Moetez-Fradi/Presentation-Selecao-TRSYP/pitch/web-deck-preview/s09.jpg

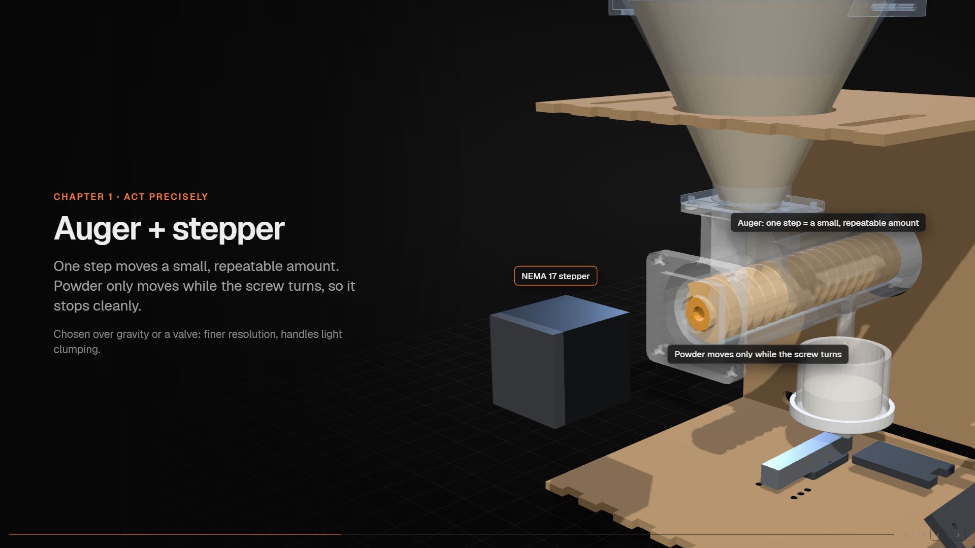
pitch/web-deck-preview/s09.jpg
