Moetez-Fradi/Presentation-Selecao-TRSYP/pitch/web-deck-preview/s16.jpg

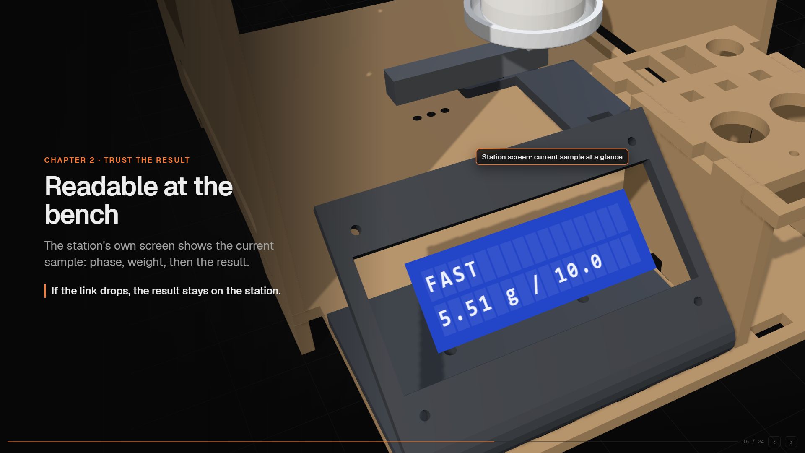
pitch/web-deck-preview/s16.jpg
