Moetez-Fradi/Presentation-Selecao-TRSYP/pitch/screenshots/c-chart2.png

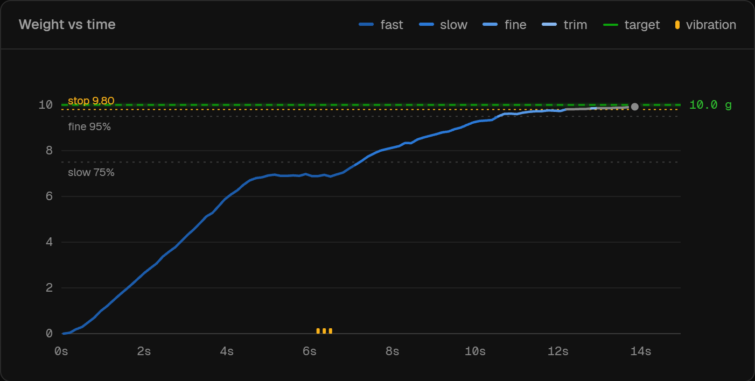
pitch/screenshots/c-chart2.png
