Moetez-Fradi/Presentation-Selecao-TRSYP/pitch/screenshots/c-compare.png

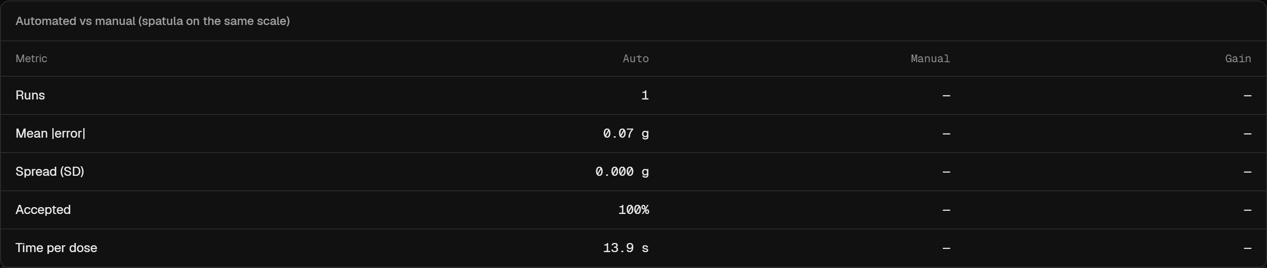
pitch/screenshots/c-compare.png
