Moetez-Fradi/Presentation-Selecao-TRSYP/pitch/screenshots/c-dev.png

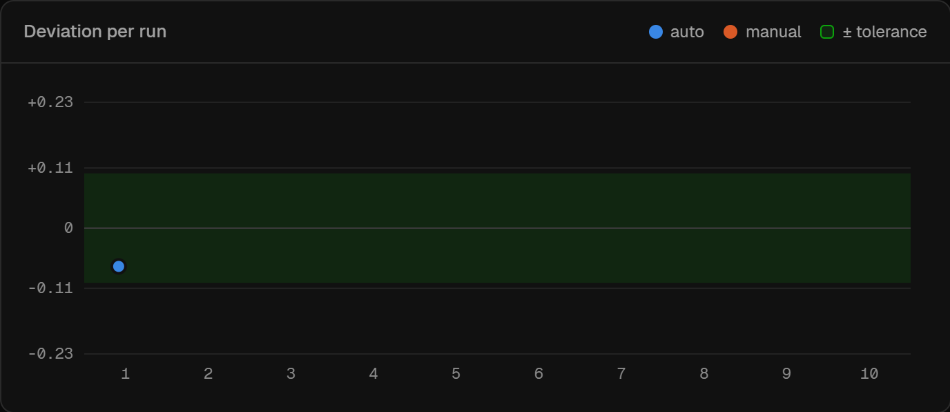
pitch/screenshots/c-dev.png
