Moetez-Fradi/Presentation-Selecao-TRSYP/pitch/screenshots/c-overshoot.png

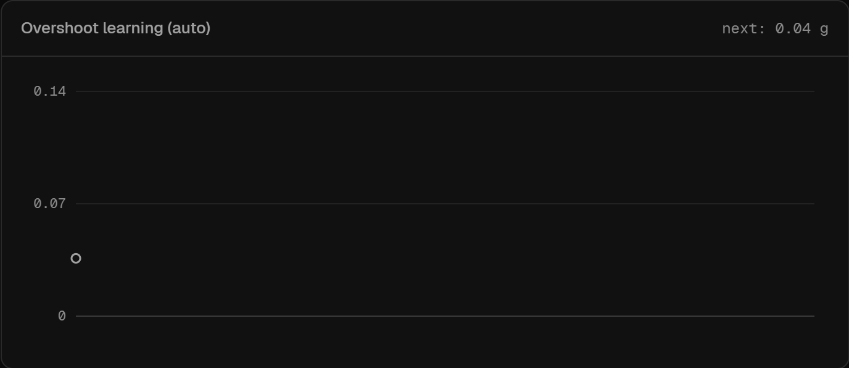
pitch/screenshots/c-overshoot.png
