Moetez-Fradi/Presentation-Selecao-TRSYP/pitch/screenshots/c-record.png

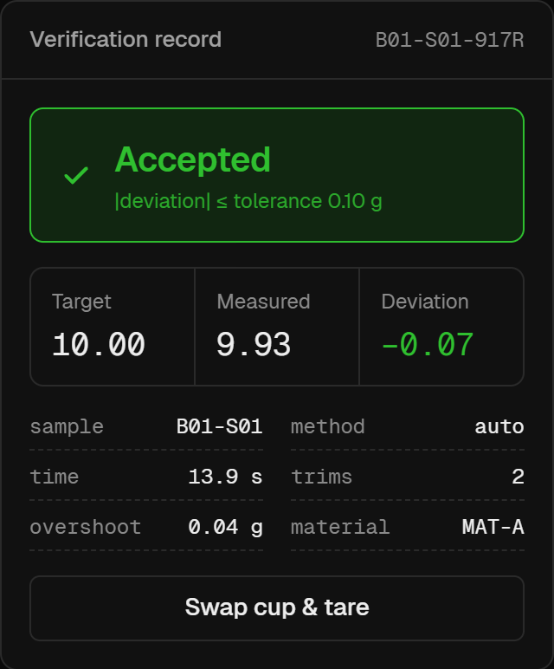
pitch/screenshots/c-record.png
