Moetez-Fradi/Presentation-Selecao-TRSYP/pitch/screenshots/c-twin.png

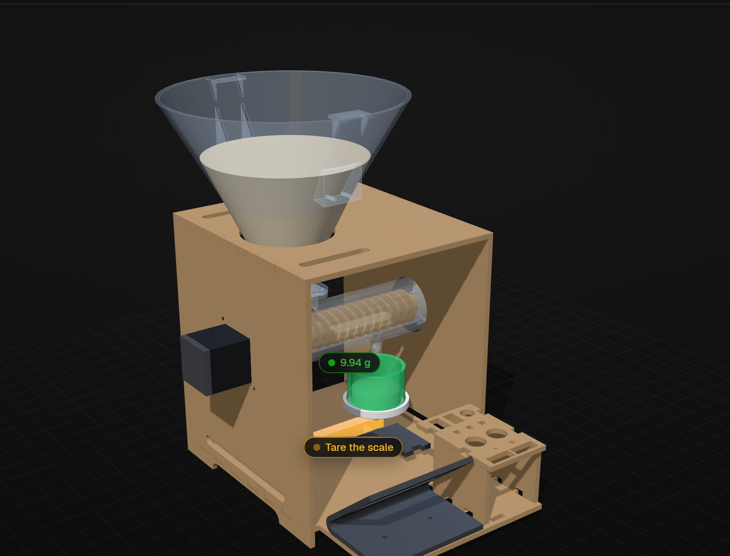
pitch/screenshots/c-twin.png
