Moetez-Fradi/Presentation-Selecao-TRSYP/pitch/screenshots/log.png

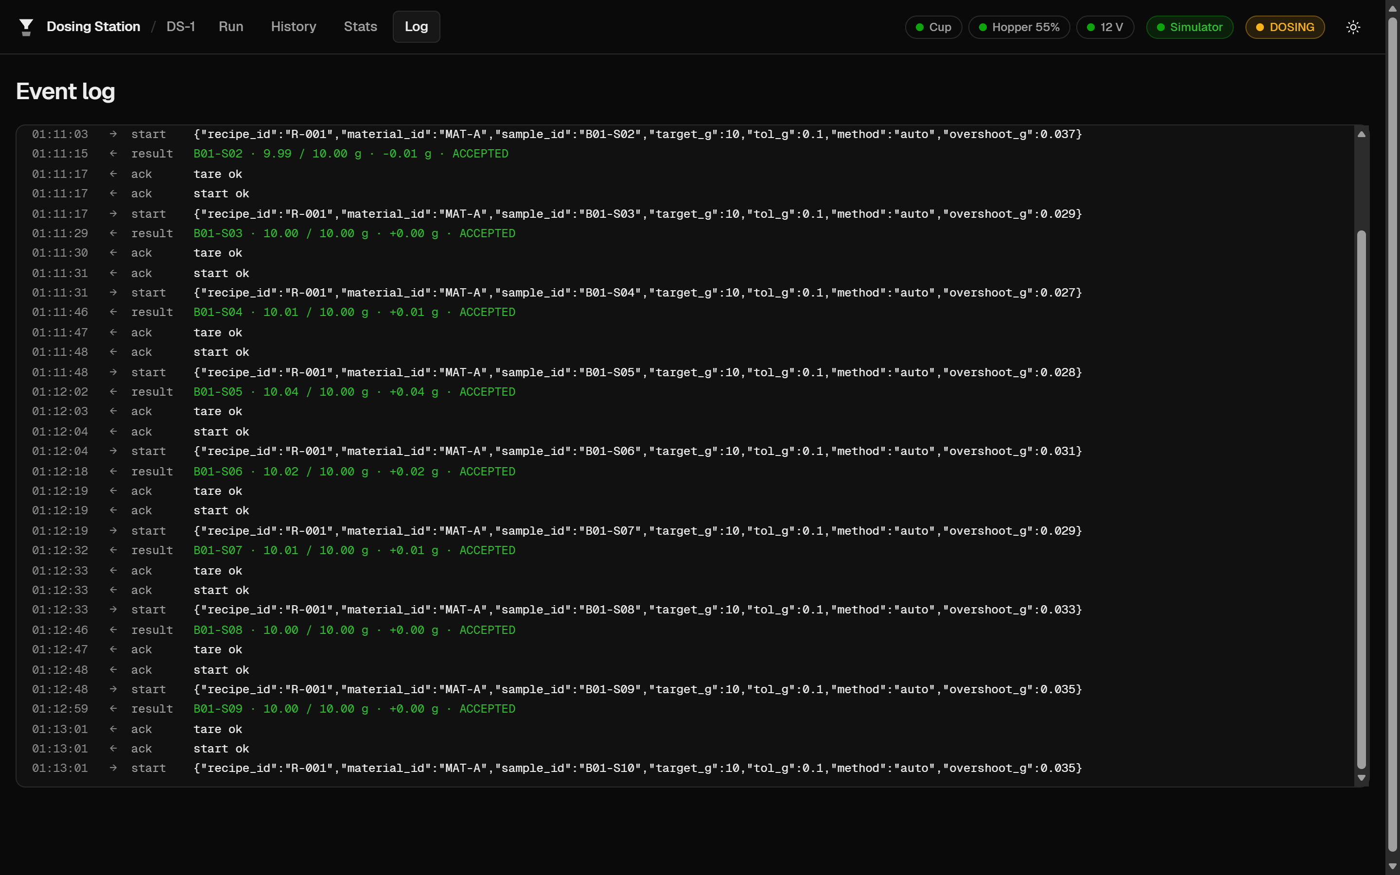
pitch/screenshots/log.png
