Moetez-Fradi/Presentation-Selecao-TRSYP/pitch/screenshots/run-dosing.png

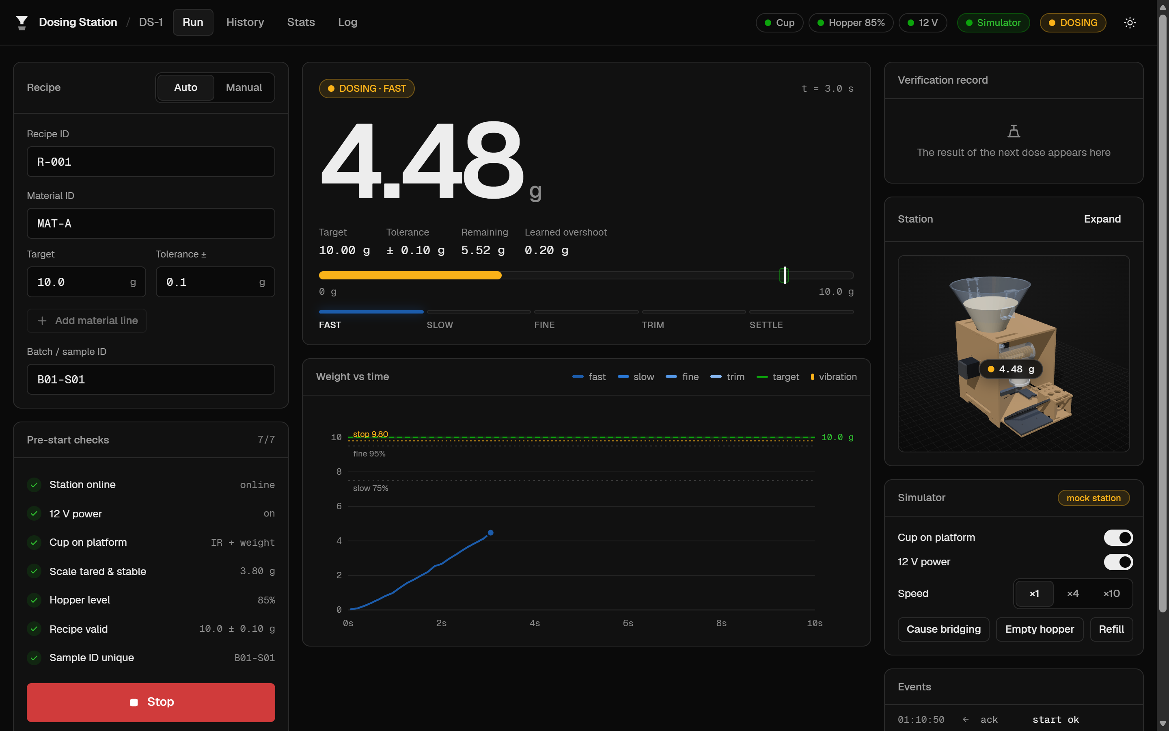
pitch/screenshots/run-dosing.png
