Moetez-Fradi/Presentation-Selecao-TRSYP/pitch/screenshots/stats.png

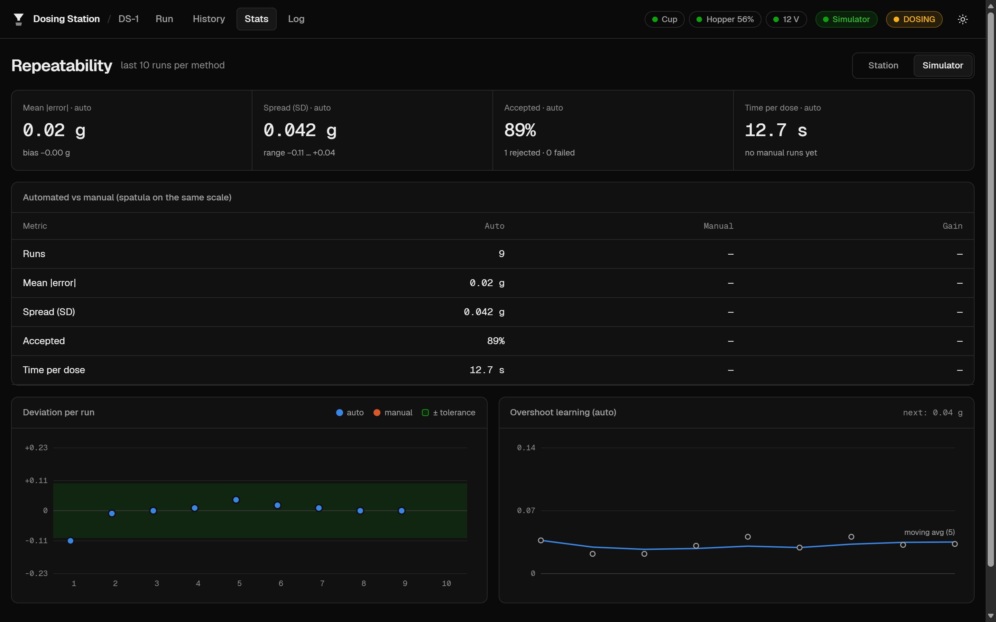
pitch/screenshots/stats.png
