Moetez-Fradi/Presentation-Selecao-TRSYP/pitch/screenshots/twin.png

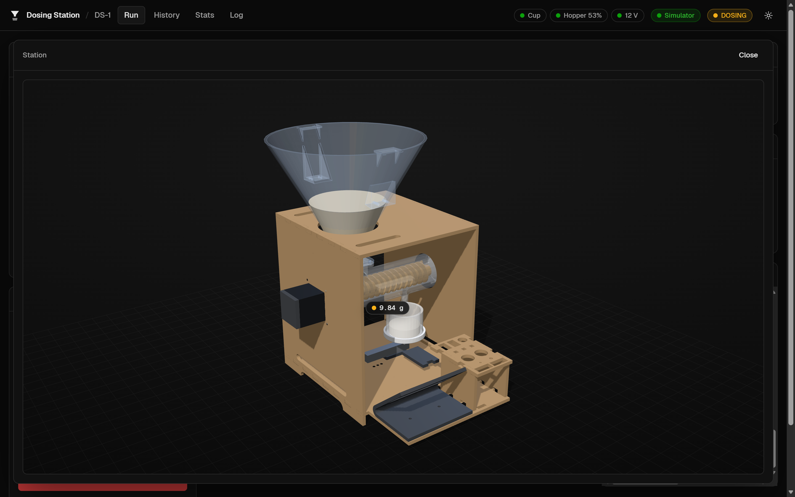
pitch/screenshots/twin.png
