Moetez-Fradi/Presentation-Selecao-TRSYP/pitch/web-deck-preview/s01.jpg

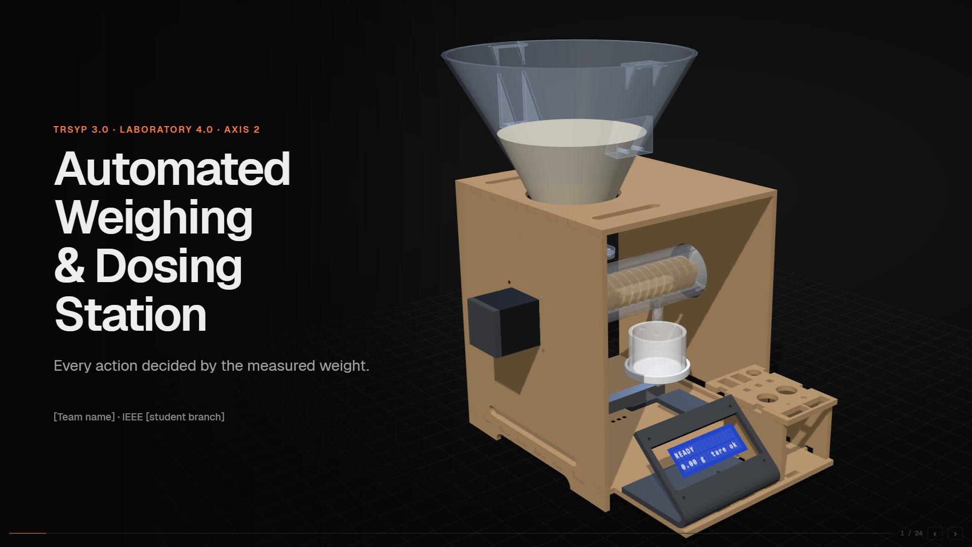
pitch/web-deck-preview/s01.jpg
