Moetez-Fradi/Presentation-Selecao-TRSYP/pitch/web-deck-preview/s02.jpg

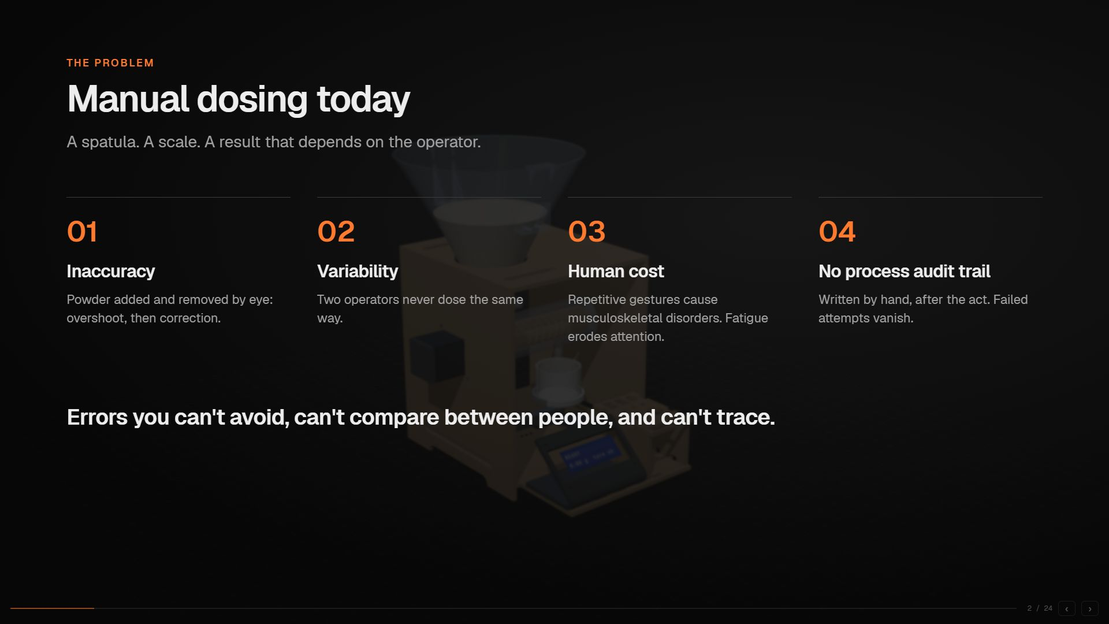
pitch/web-deck-preview/s02.jpg
