Moetez-Fradi/Presentation-Selecao-TRSYP/pitch/web-deck-preview/s03.jpg

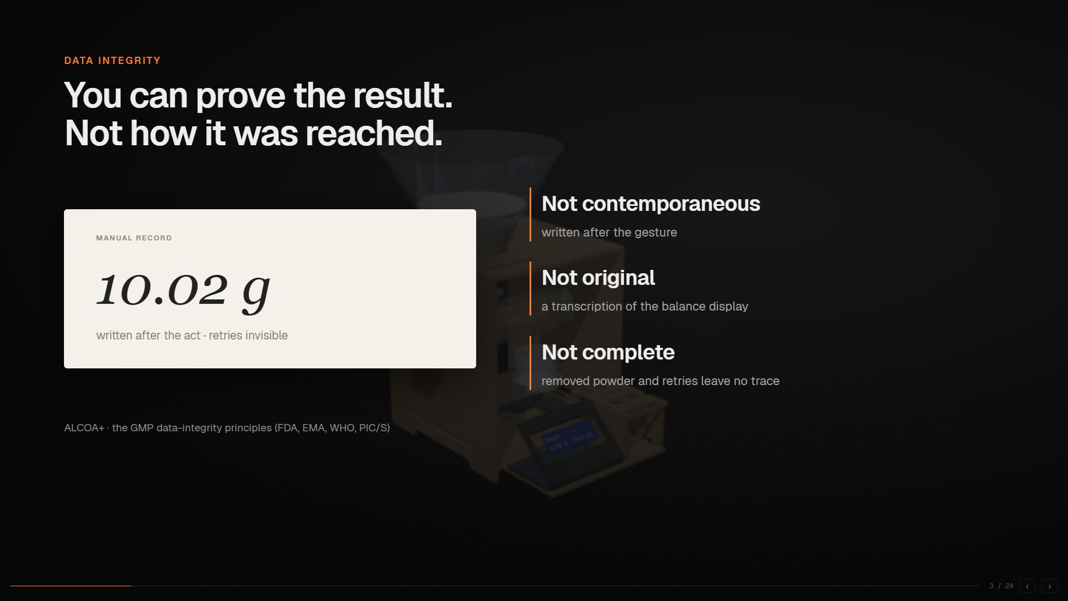
pitch/web-deck-preview/s03.jpg
