Moetez-Fradi/Presentation-Selecao-TRSYP/pitch/web-deck-preview/s04.jpg

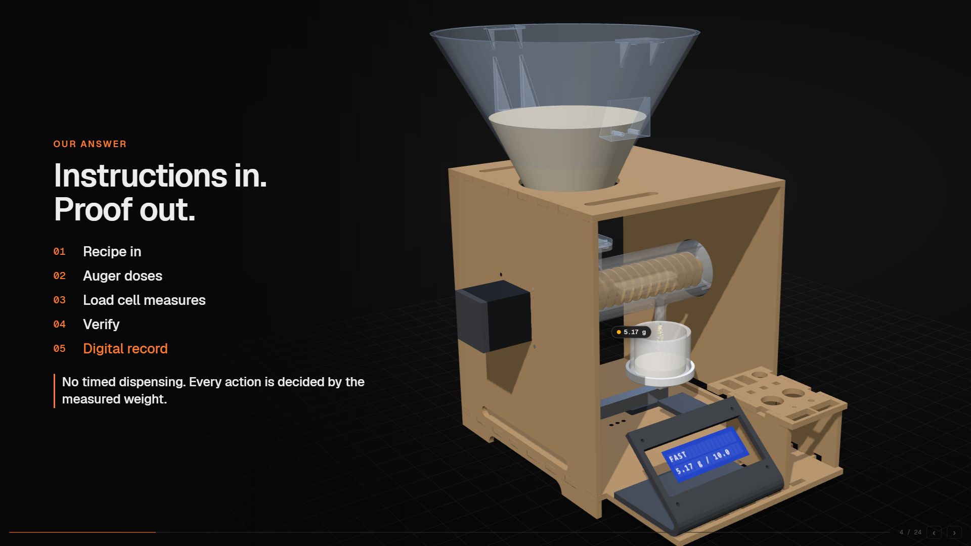
pitch/web-deck-preview/s04.jpg
