Moetez-Fradi/Presentation-Selecao-TRSYP/pitch/web-deck-preview/s05.jpg

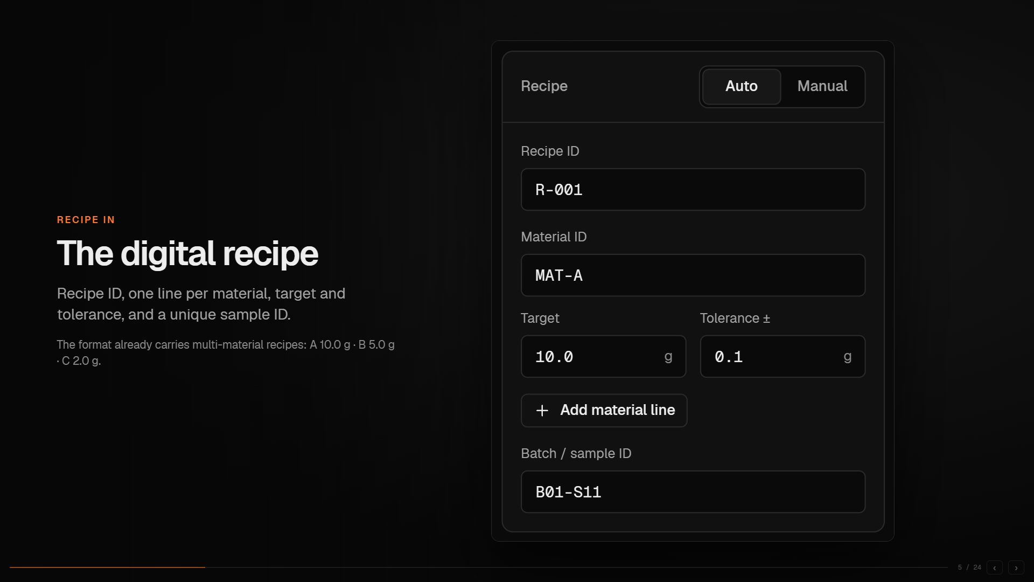
pitch/web-deck-preview/s05.jpg
