Moetez-Fradi/Presentation-Selecao-TRSYP/pitch/web-deck-preview/s06.jpg

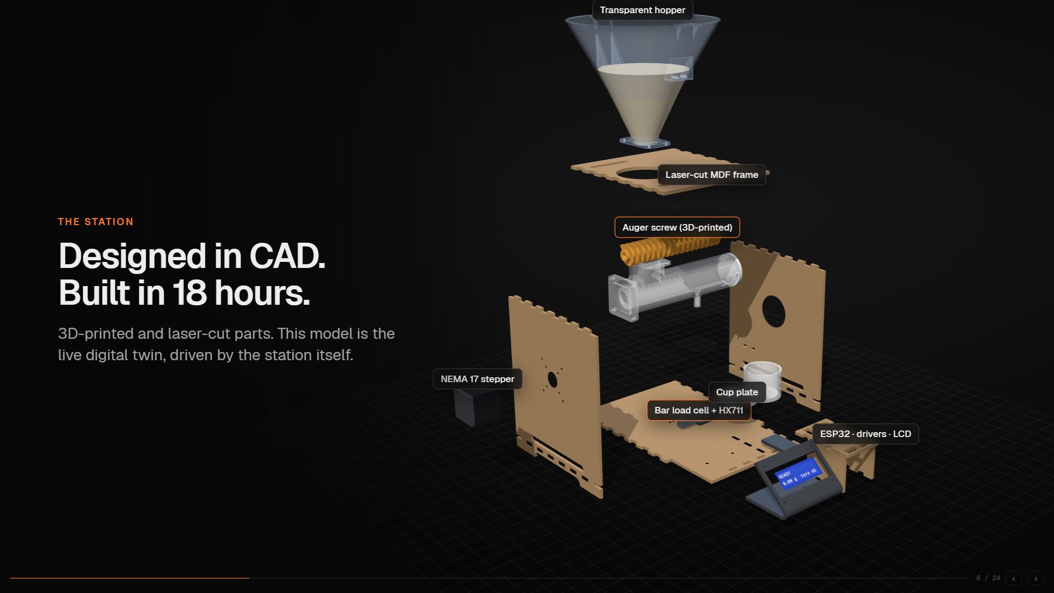
pitch/web-deck-preview/s06.jpg
