Moetez-Fradi/Presentation-Selecao-TRSYP/pitch/web-deck-preview/s07.jpg

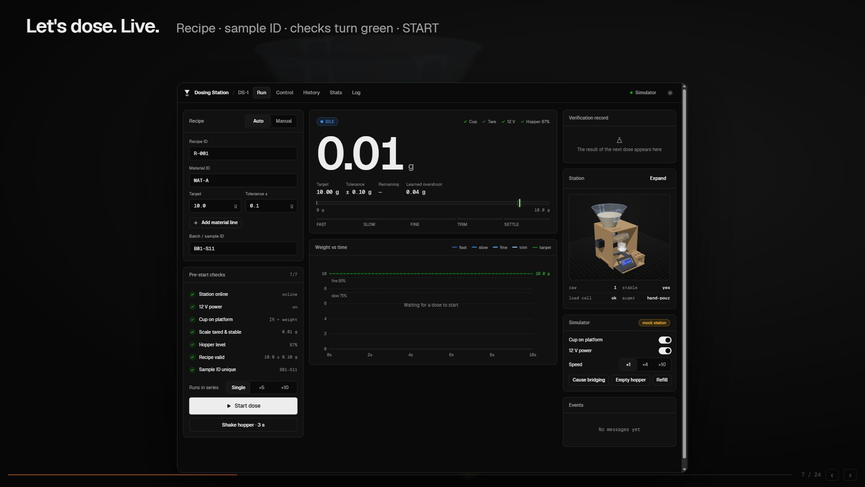
pitch/web-deck-preview/s07.jpg
