Moetez-Fradi/Presentation-Selecao-TRSYP/pitch/web-deck-preview/s08.jpg

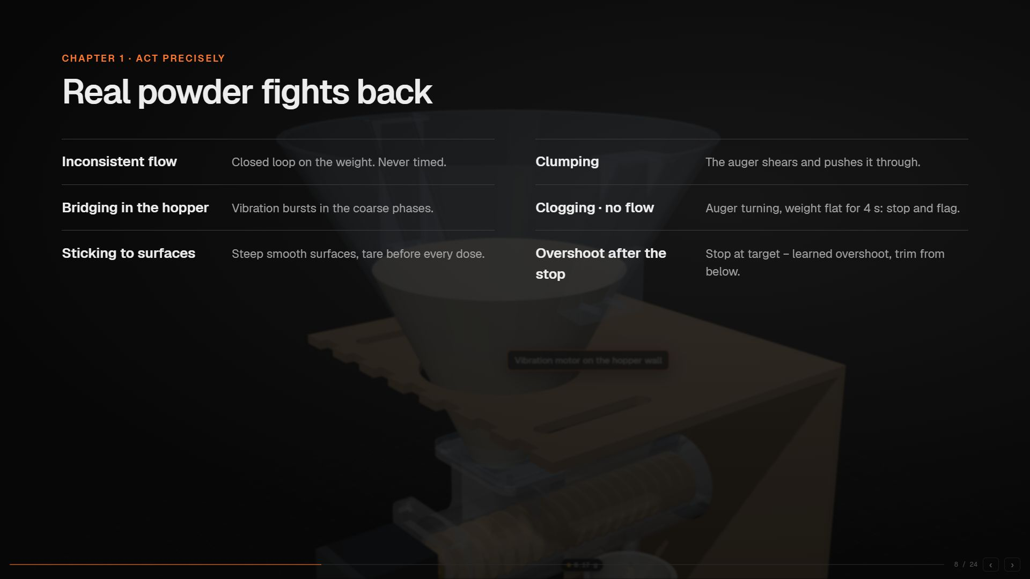
pitch/web-deck-preview/s08.jpg
