Moetez-Fradi/Presentation-Selecao-TRSYP/pitch/web-deck-preview/s10.jpg

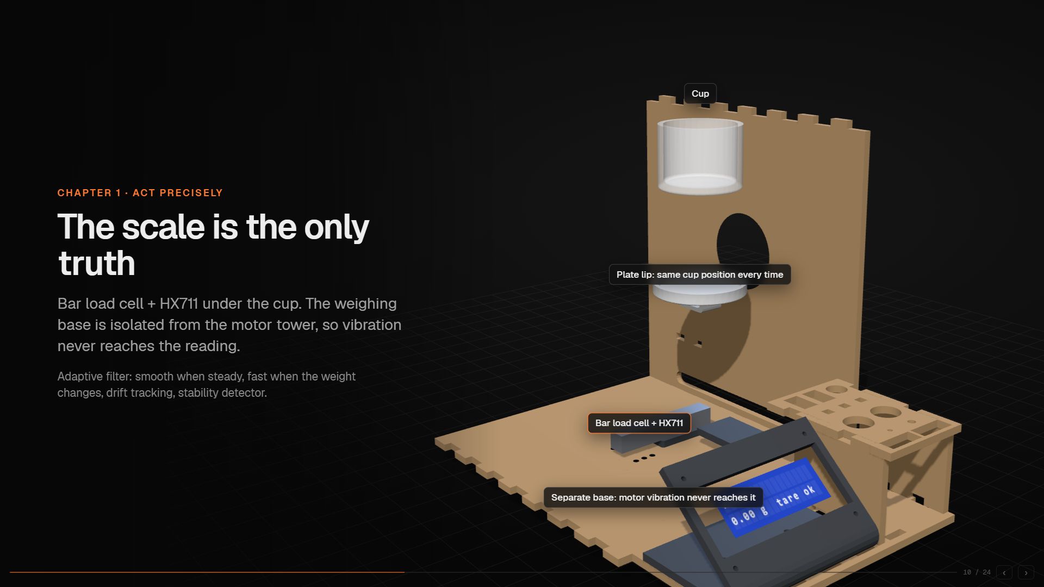
pitch/web-deck-preview/s10.jpg
