Moetez-Fradi/Presentation-Selecao-TRSYP/pitch/web-deck-preview/s11.jpg

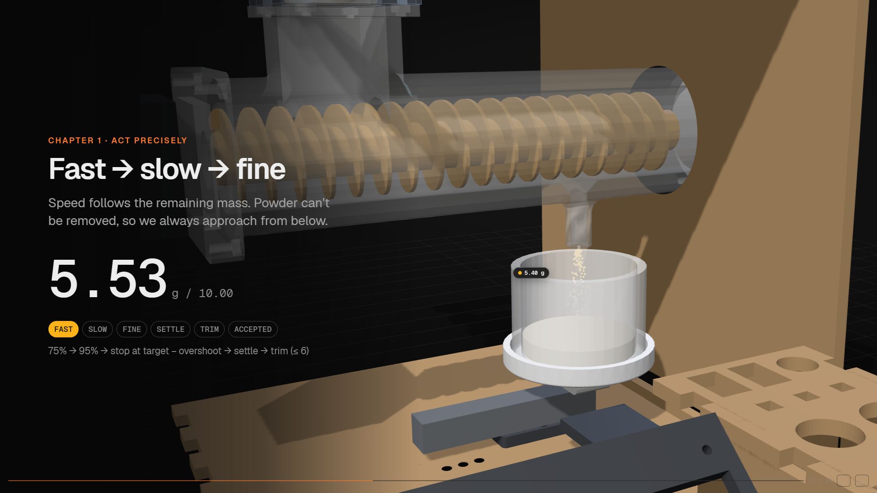
pitch/web-deck-preview/s11.jpg
