Moetez-Fradi/Presentation-Selecao-TRSYP/pitch/web-deck-preview/s12.jpg

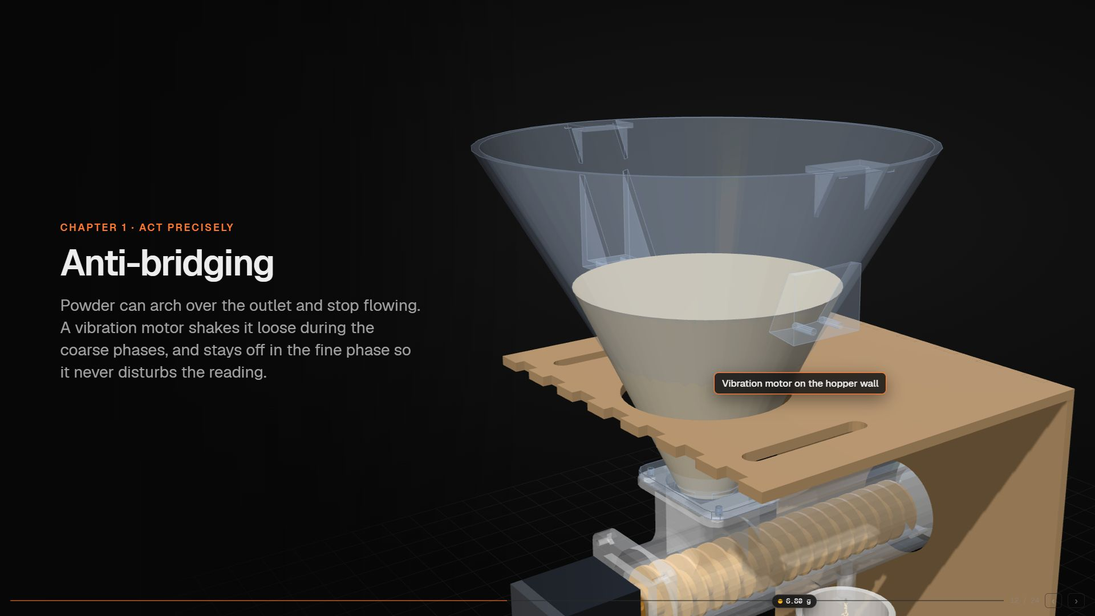
pitch/web-deck-preview/s12.jpg
