Moetez-Fradi/Presentation-Selecao-TRSYP/pitch/web-deck-preview/s13.jpg

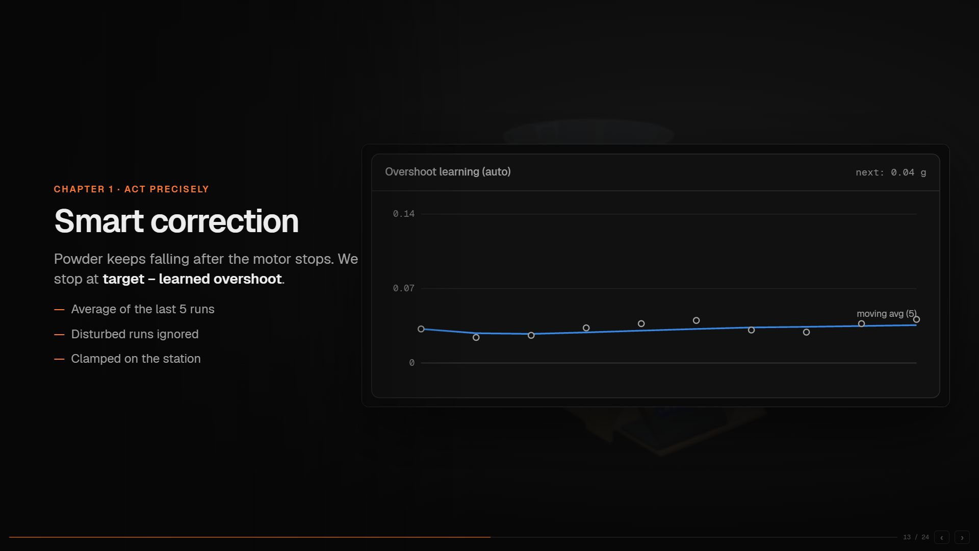
pitch/web-deck-preview/s13.jpg
