Moetez-Fradi/Presentation-Selecao-TRSYP/pitch/web-deck-preview/s14.jpg

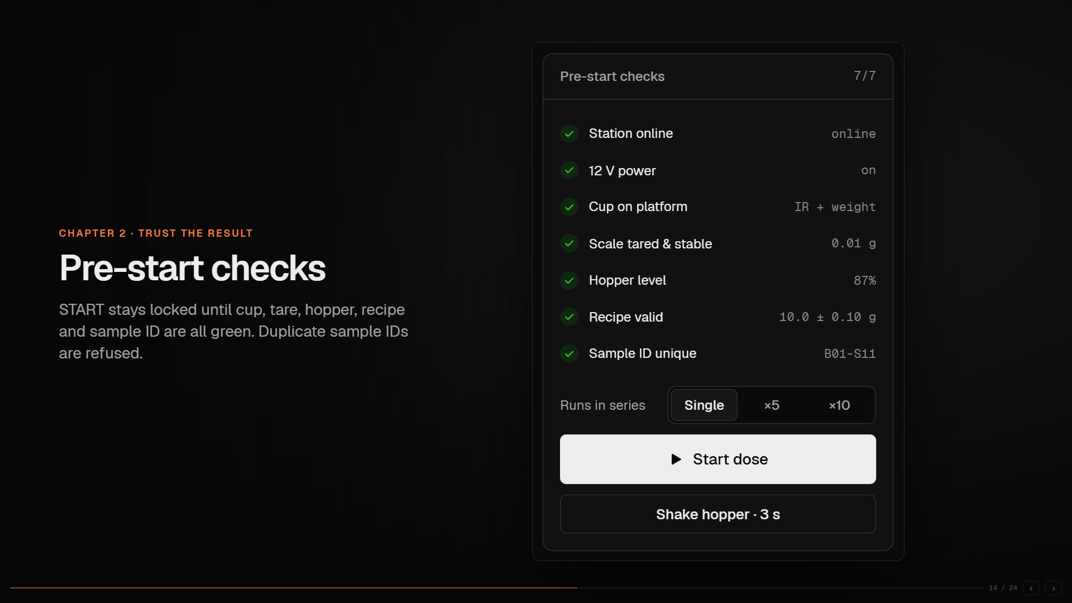
pitch/web-deck-preview/s14.jpg
