Moetez-Fradi/Presentation-Selecao-TRSYP/pitch/web-deck-preview/s15.jpg

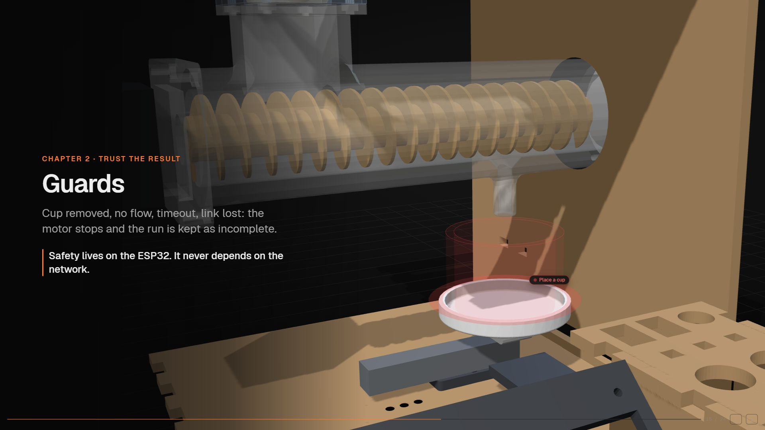
pitch/web-deck-preview/s15.jpg
