Moetez-Fradi/Presentation-Selecao-TRSYP/pitch/web-deck-preview/s17.jpg

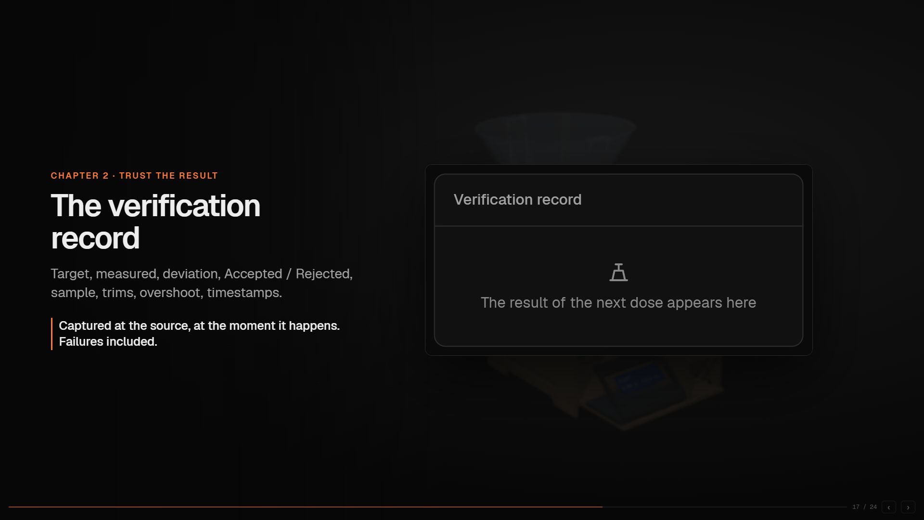
pitch/web-deck-preview/s17.jpg
