Moetez-Fradi/Presentation-Selecao-TRSYP/pitch/web-deck-preview/s18.jpg

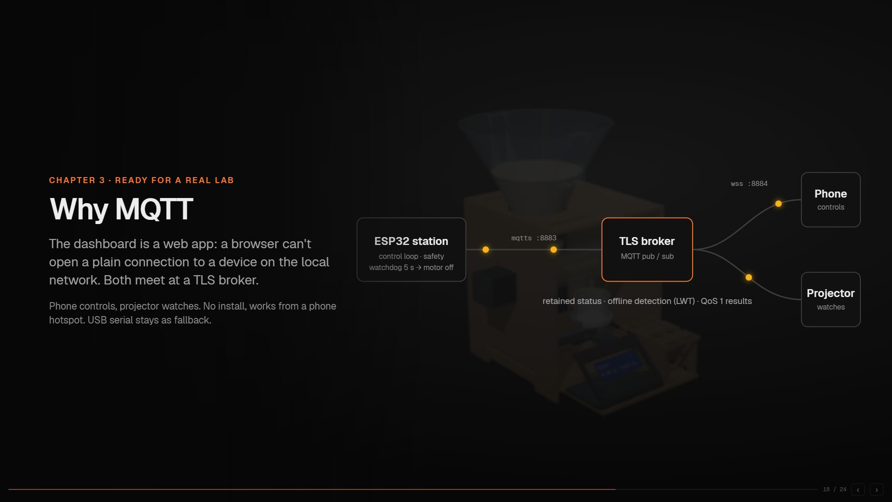
pitch/web-deck-preview/s18.jpg
