Moetez-Fradi/Presentation-Selecao-TRSYP/pitch/web-deck-preview/s19.jpg

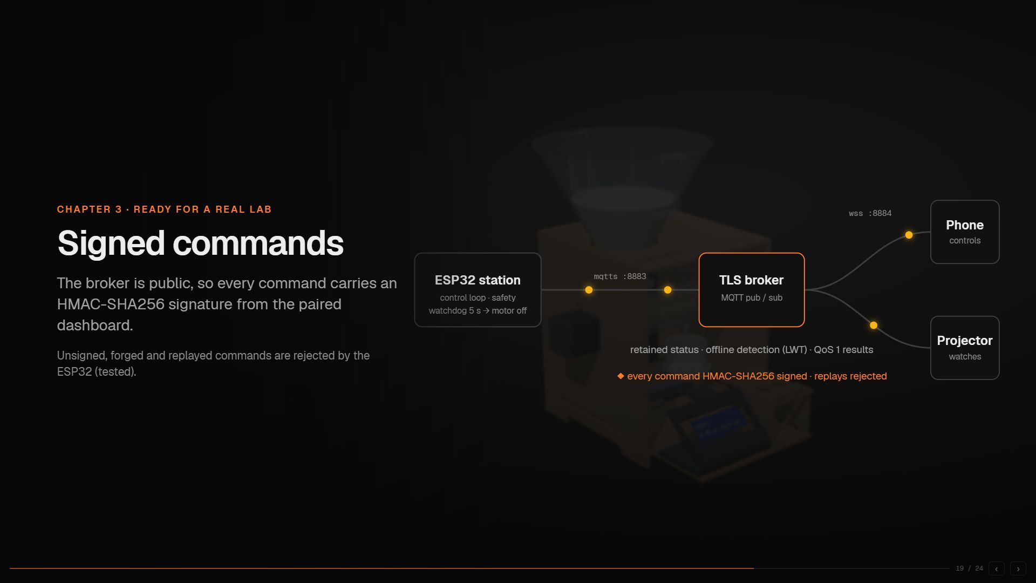
pitch/web-deck-preview/s19.jpg
