Moetez-Fradi/Presentation-Selecao-TRSYP/pitch/web-deck-preview/s20.jpg

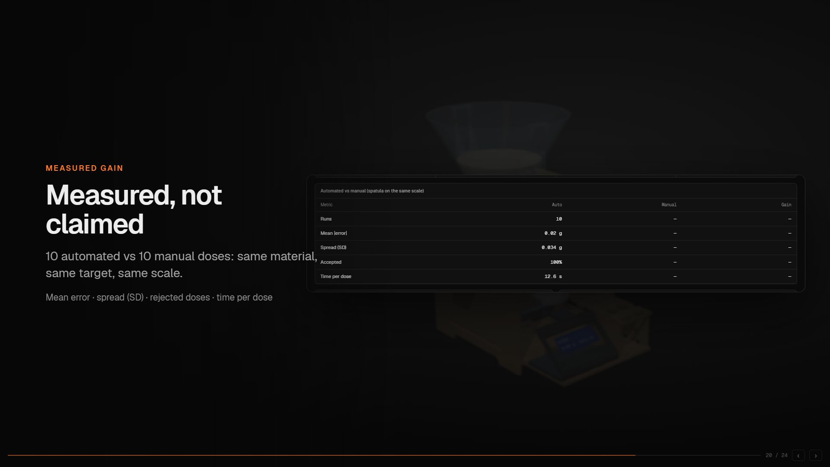
pitch/web-deck-preview/s20.jpg
