Moetez-Fradi/Presentation-Selecao-TRSYP/pitch/web-deck-preview/s21.jpg

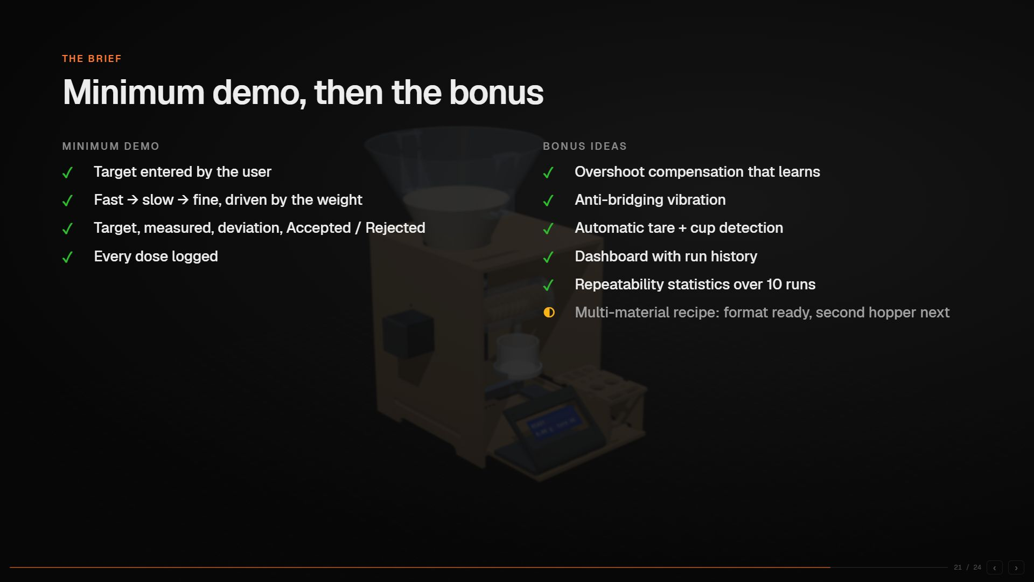
pitch/web-deck-preview/s21.jpg
