Moetez-Fradi/Presentation-Selecao-TRSYP/pitch/web-deck-preview/s22.jpg

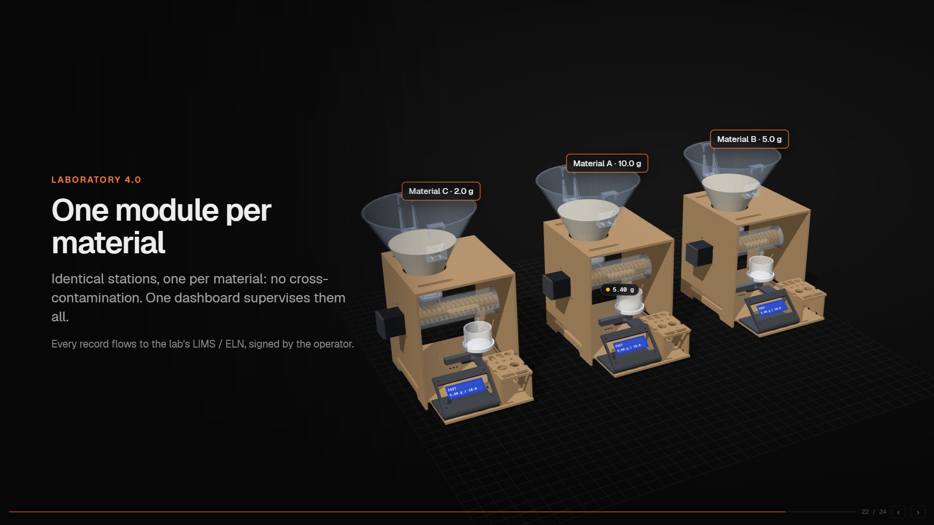
pitch/web-deck-preview/s22.jpg
