Moetez-Fradi/Presentation-Selecao-TRSYP/pitch/web-deck-preview/s23.jpg

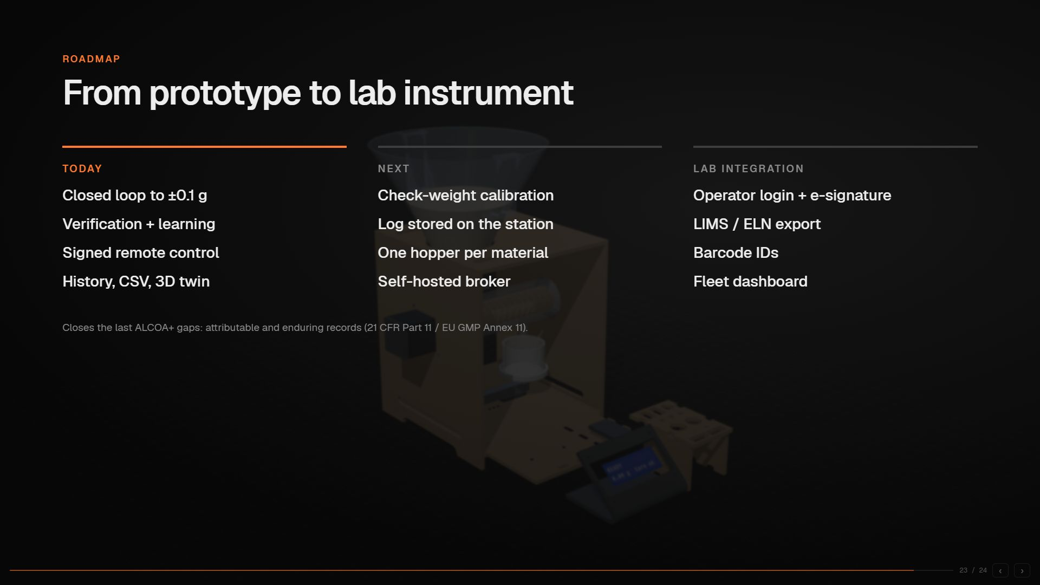
pitch/web-deck-preview/s23.jpg
