Moetez-Fradi/Presentation-Selecao-TRSYP/pitch/web-deck-preview/s24.jpg

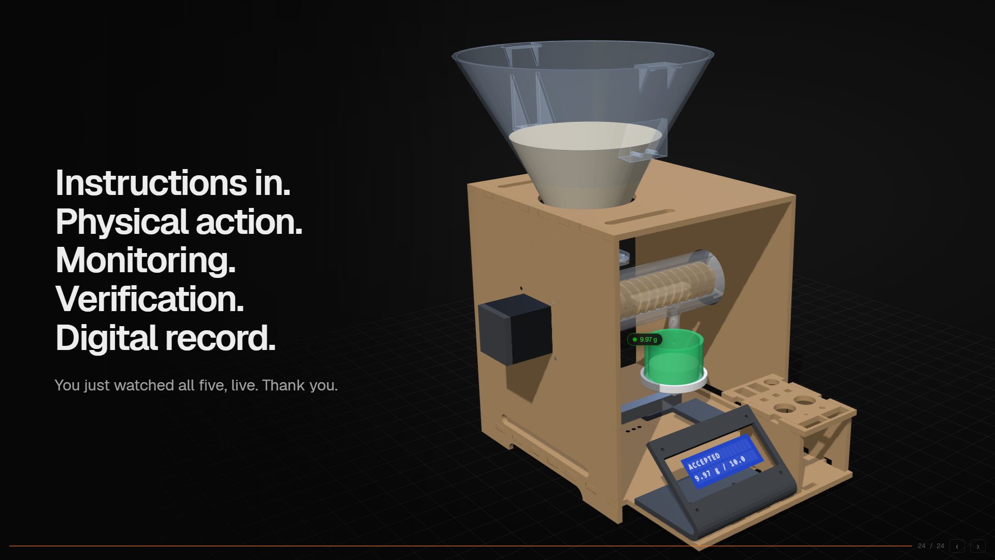
pitch/web-deck-preview/s24.jpg
