Moetez-Fradi/Presentation-Selecao-TRSYP/dashboard/public/models/loadcell-fixer.stl

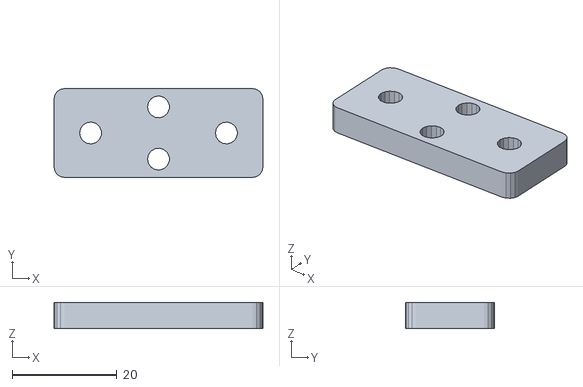
[picture p36: CAD file, 2026-10-17]
dashboard/public/models/loadcell-fixer.stl
40.0 x 17.0 x 5.00
