Moetez-Fradi/Presentation-Selecao-TRSYP/dashboard/public/models/right-side.dxf

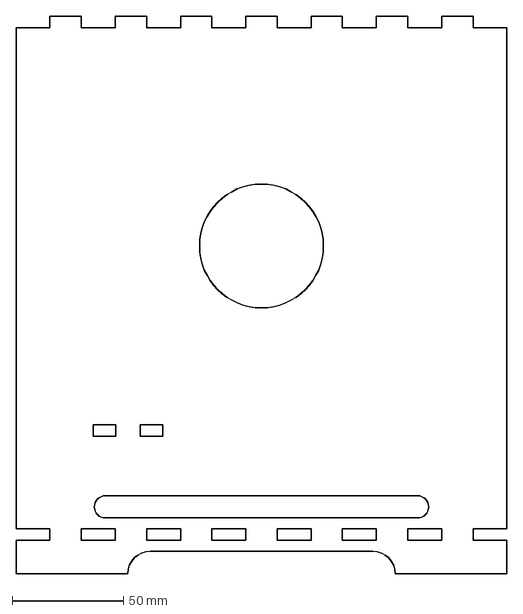
[picture p37: CAD file, 2026-10-17]
dashboard/public/models/right-side.dxf
220.0 x 250.0 mm
