Moetez-Fradi/Presentation-Selecao-TRSYP/dashboard/public/models/left-side-motor.dxf

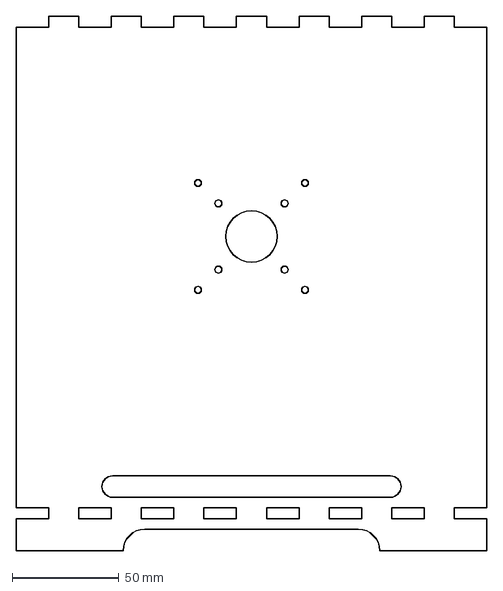
[picture p38: CAD file, 2026-10-17]
dashboard/public/models/left-side-motor.dxf
220.0 x 250.0 mm
