Moetez-Fradi/Presentation-Selecao-TRSYP/dashboard/public/models/cup-plate.stl

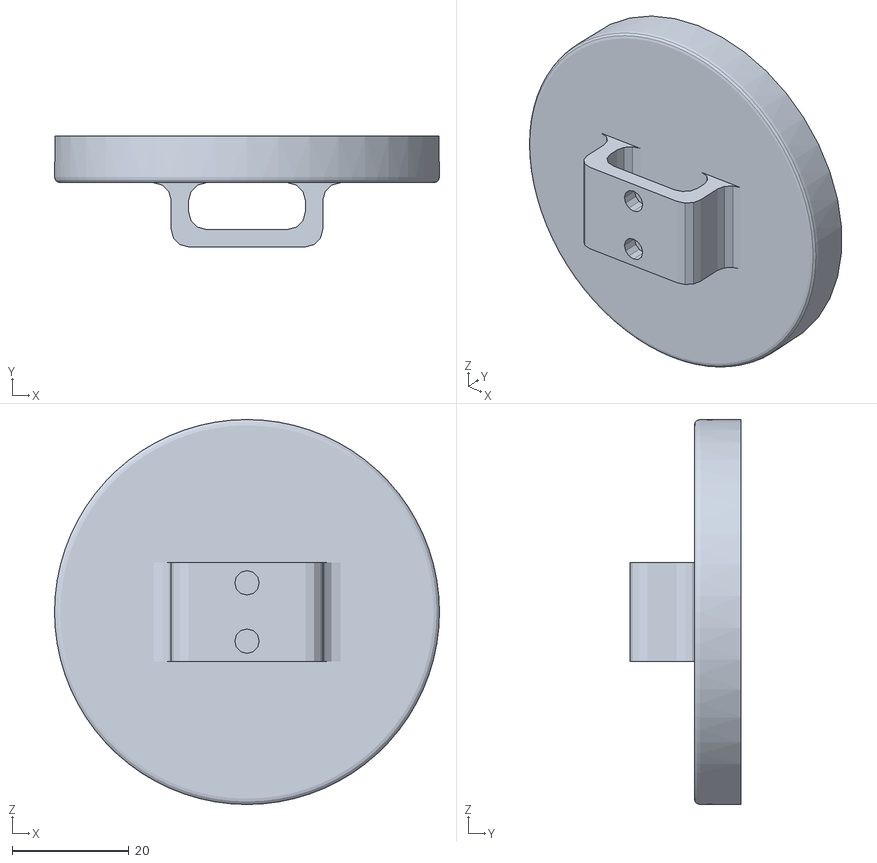
[picture p39: CAD file, 2026-10-17]
dashboard/public/models/cup-plate.stl
66.0 x 19.0 x 66.0
