Moetez-Fradi/Presentation-Selecao-TRSYP/dashboard/public/models/buttons-platform-upper.dxf

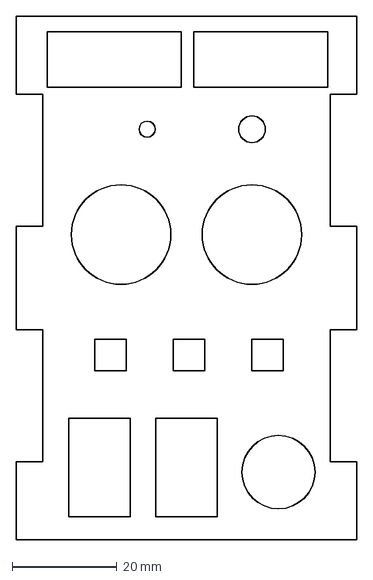
[picture p40: CAD file, 2026-10-17]
dashboard/public/models/buttons-platform-upper.dxf
65.0 x 100.0 mm
