Moetez-Fradi/Presentation-Selecao-TRSYP/dashboard/public/models/base-front-support.dxf

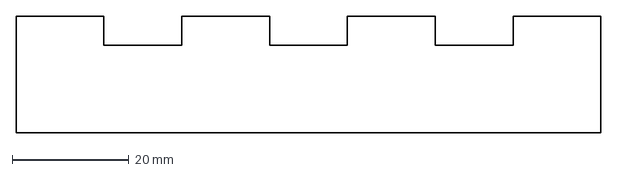
[picture p41: CAD file, 2026-10-17]
dashboard/public/models/base-front-support.dxf
100.0 x 20.0 mm
