Moetez-Fradi/Presentation-Selecao-TRSYP/dashboard/public/models/tube.stl

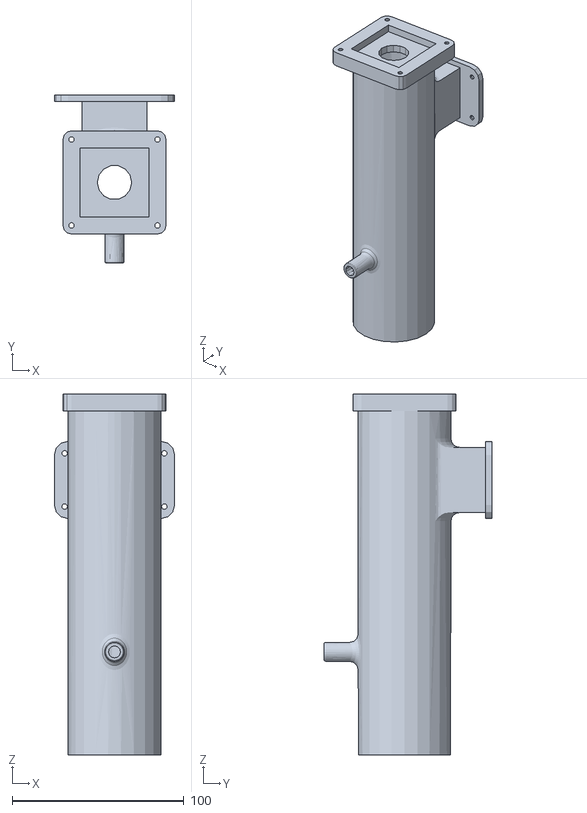
[picture p42: CAD file, 2026-10-17]
dashboard/public/models/tube.stl
70.0 x 98.0 x 210.0
