Moetez-Fradi/Presentation-Selecao-TRSYP/dashboard/public/models/buttons-platform-side.dxf

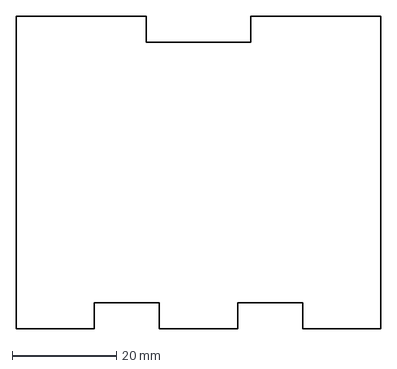
[picture p43: CAD file, 2026-10-17]
dashboard/public/models/buttons-platform-side.dxf
70.0 x 60.0 mm
