Moetez-Fradi/Presentation-Selecao-TRSYP/dashboard/public/models/lower-side.dxf

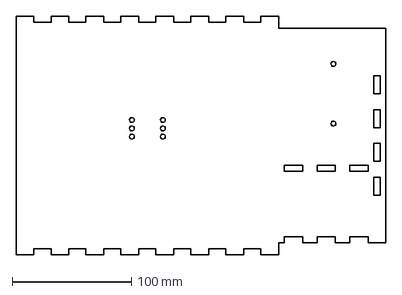
[picture p44: CAD file, 2026-10-17]
dashboard/public/models/lower-side.dxf
310.0 x 200.0 mm
