Moetez-Fradi/Presentation-Selecao-TRSYP/dashboard/public/models/lcd-holder.stl

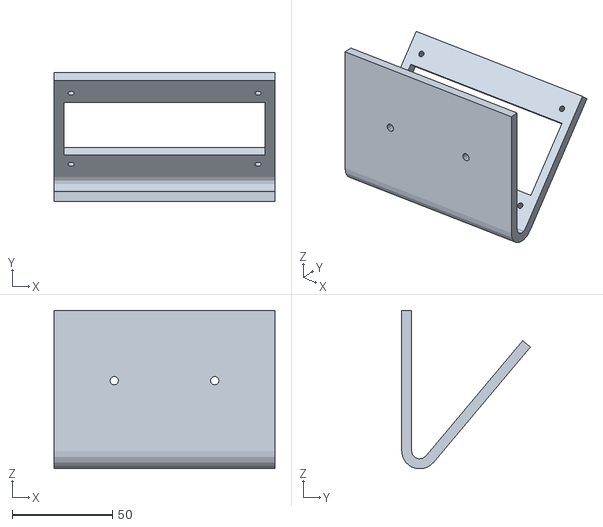
[picture p45: CAD file, 2026-10-17]
dashboard/public/models/lcd-holder.stl
110.0 x 64.1 x 78.9
