Moetez-Fradi/Presentation-Selecao-TRSYP/dashboard/public/models/cup.stl

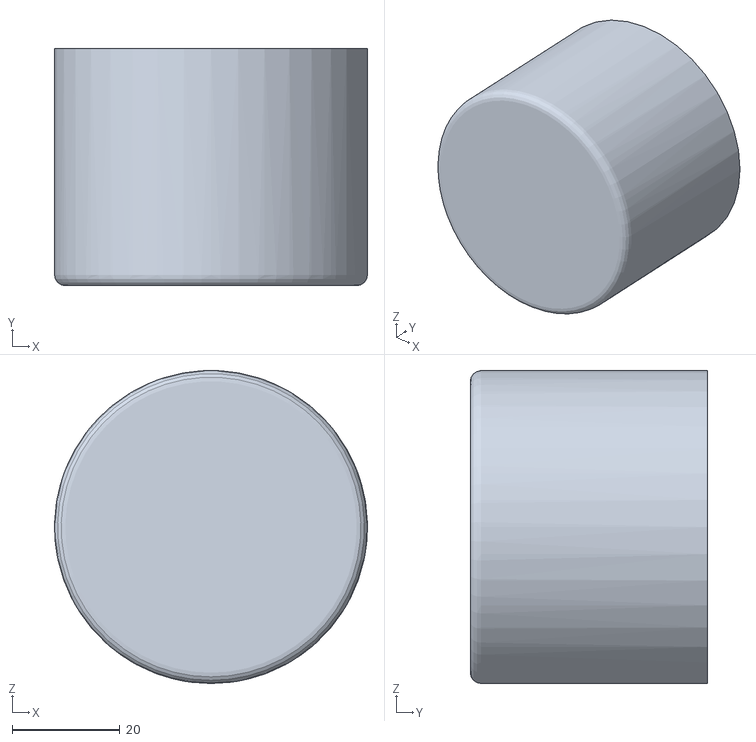
[picture p46: CAD file, 2026-10-17]
dashboard/public/models/cup.stl
58.0 x 44.0 x 58.0
