Moetez-Fradi/Presentation-Selecao-TRSYP/dashboard/public/models/hopper.stl

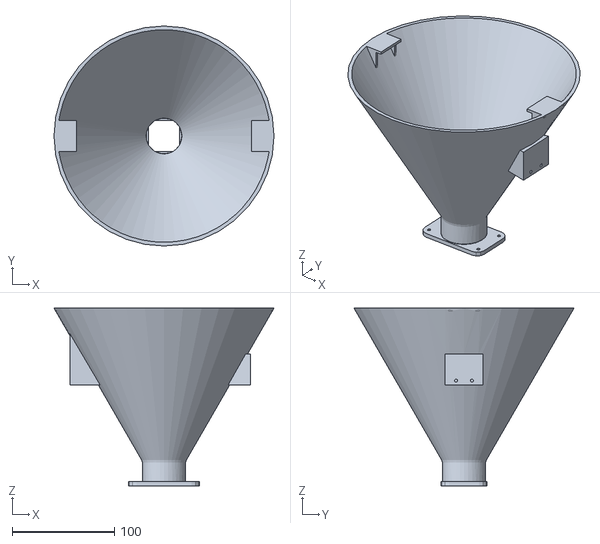
[picture p47: CAD file, 2026-10-17]
dashboard/public/models/hopper.stl
215.6 x 215.6 x 174.0
