Moetez-Fradi/Presentation-Selecao-TRSYP/dashboard/public/models/irsensor-support.dxf

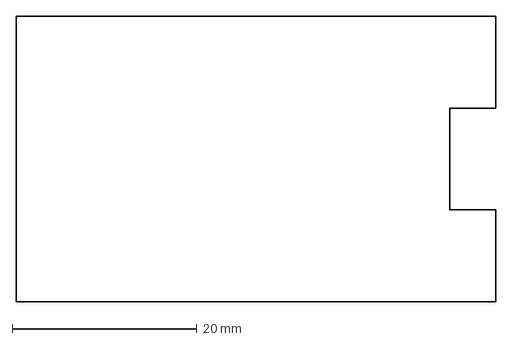
[picture p48: CAD file, 2026-10-17]
dashboard/public/models/irsensor-support.dxf
52.0 x 31.0 mm
