Moetez-Fradi/Presentation-Selecao-TRSYP/dashboard/public/models/upper-side.dxf

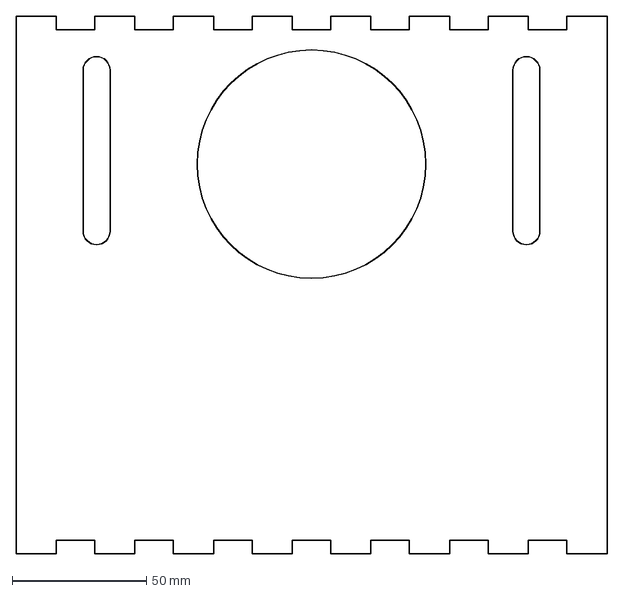
[picture p49: CAD file, 2026-10-17]
dashboard/public/models/upper-side.dxf
220.0 x 200.0 mm
