Moetez-Fradi/Presentation-Selecao-TRSYP/dashboard/public/models/tube-cover.stl

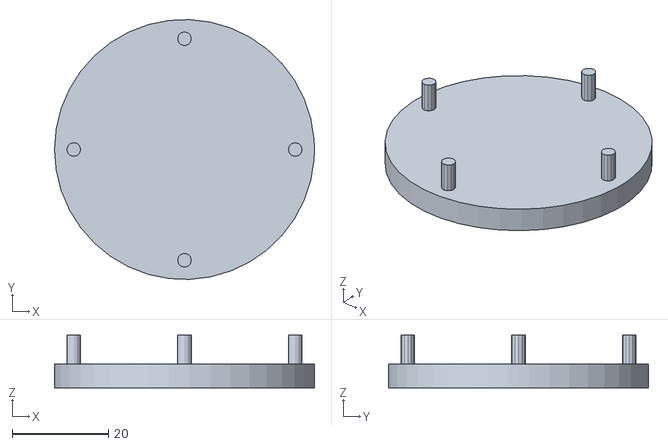
[picture p50: CAD file, 2026-10-17]
dashboard/public/models/tube-cover.stl
54.0 x 54.0 x 11.0
