Moetez-Fradi/Presentation-Selecao-TRSYP/dashboard/public/models/auger.stl

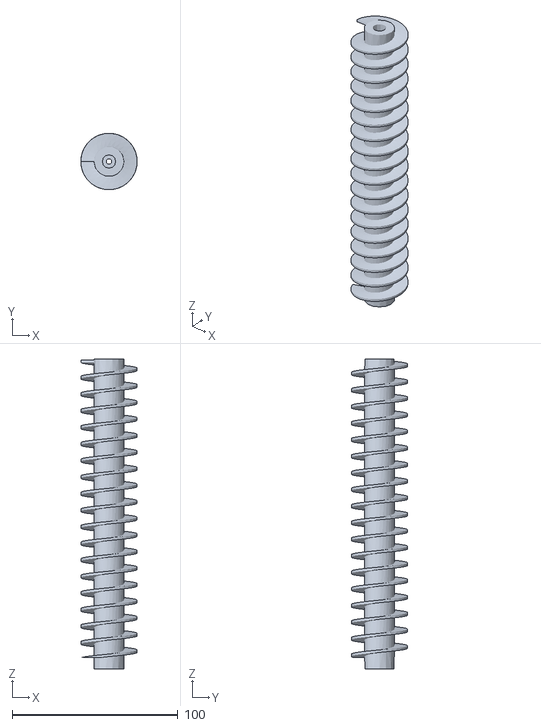
[picture p51: CAD file, 2026-10-17]
dashboard/public/models/auger.stl
34.0 x 34.0 x 187.0
