Moetez-Fradi/Presentation-Selecao-TRSYP/station_esp32_wiring_map.png

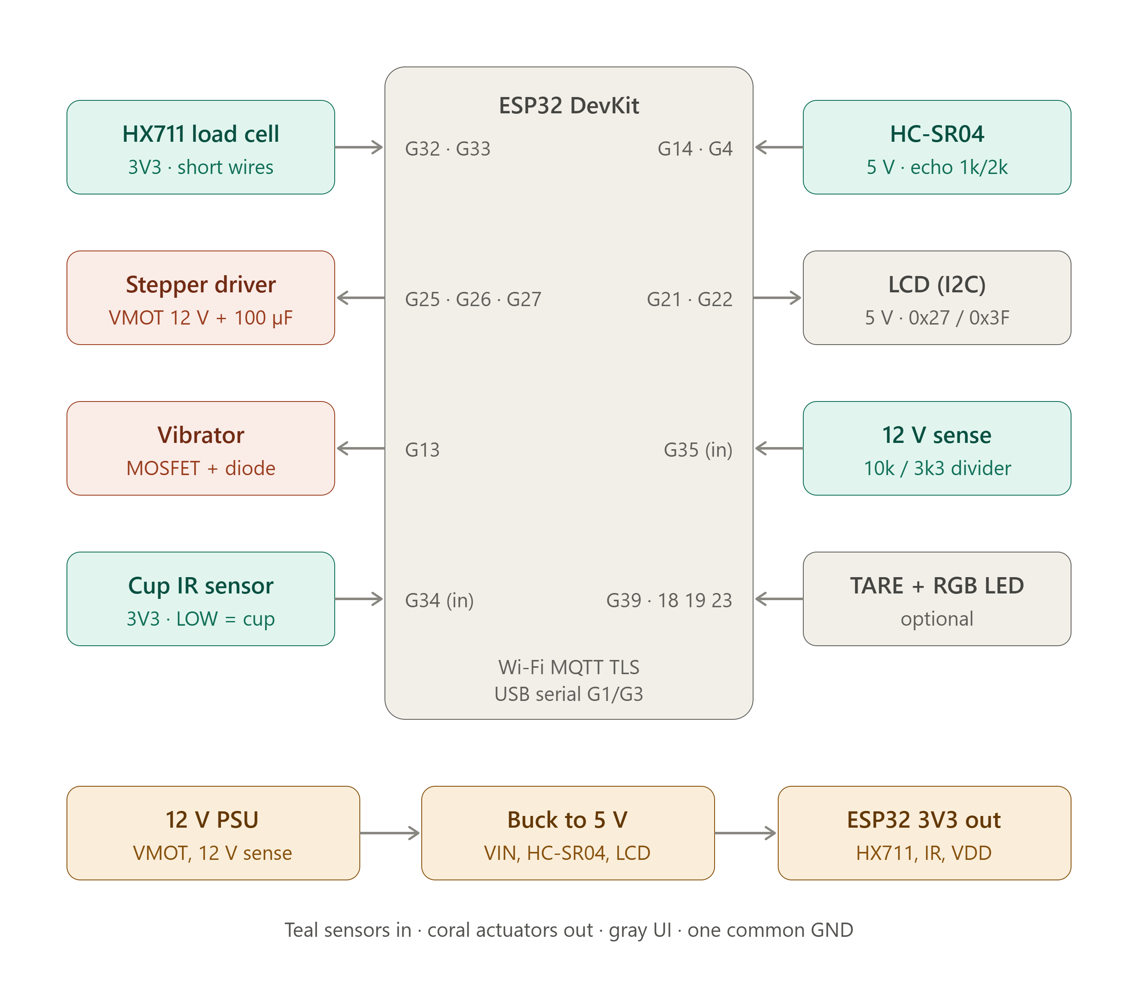
station_esp32_wiring_map.png
