Moetez-Fradi/Presentation-Selecao-TRSYP/pitch/screenshots/history.png

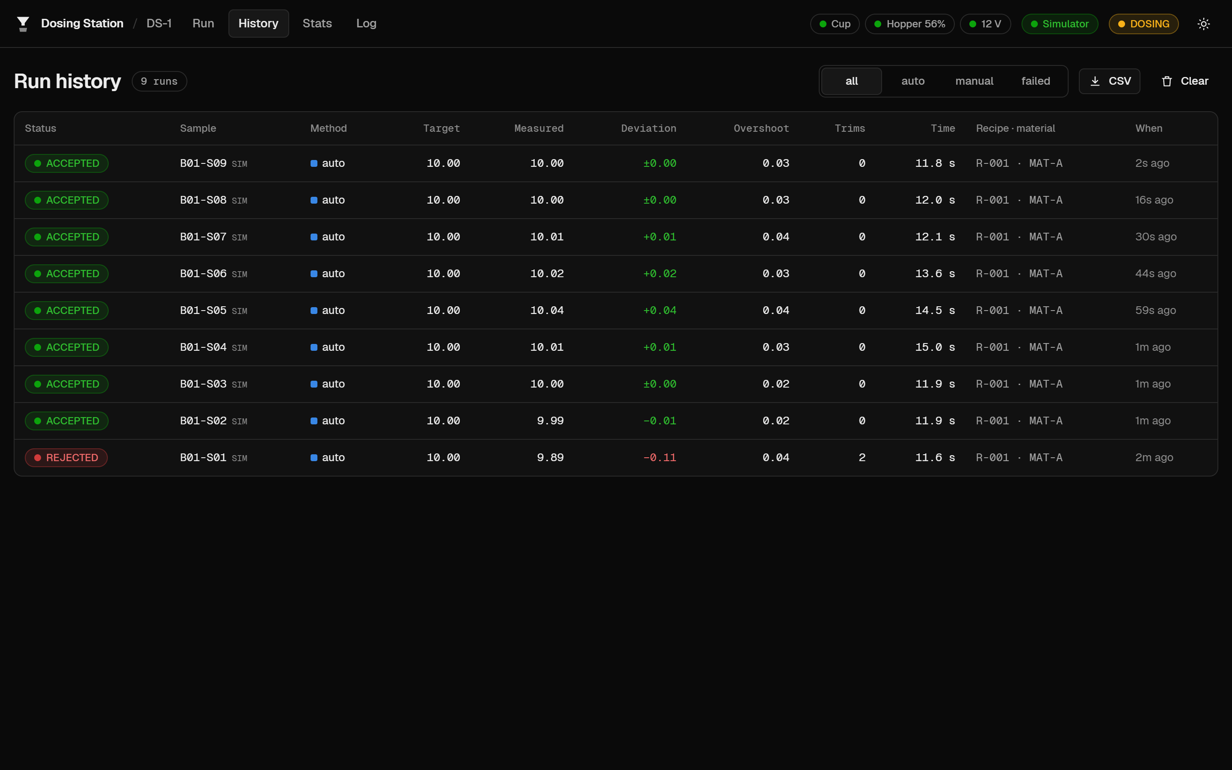
pitch/screenshots/history.png
