Moetez-Fradi/Presentation-Selecao-TRSYP/firmware/station/src/net/root_cas.h

#pragma once
// Trusted root CAs for the MQTT broker (TLS). One string, several PEM blocks.
//   ISRG Root X1            96:BC:EC:06:...:08:C6  (Let's Encrypt: HiveMQ Cloud, test.mosquitto.org)  until 2035
//   Amazon Root CA 1        8E:CD:E6:88:...:19:6E  (broker.hivemq.com public broker)                    until 2038
//   DigiCert Global Root G2 CB:3C:CB:B7:...:CB:5F  (broker.emqx.io public broker)                       until 2038
// Verified against each broker with openssl on 2026-10-16.
static const char ROOT_CAS[] = R"PEM(-----BEGIN CERTIFICATE-----
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
-----END CERTIFICATE-----
-----BEGIN CERTIFICATE-----
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
rqXRfboQnoZsG4q5WTP468SQvvG5
-----END CERTIFICATE-----
-----BEGIN CERTIFICATE-----
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
MrY=
-----END CERTIFICATE-----
)PEM";
