Moetez-Fradi/Presentation-Selecao-TRSYP/(commit log)

2026-10-17 Dosing station: firmware, dashboard and pitch deck
    ESP32 firmware (PlatformIO), the Vite + React dashboard with its 3D twin,
    and the animated web pitch deck (dashboard/pitch.html).
    [auger.stl, base-front-support.dxf, buttons-platform-side.dxf, buttons-platform-upper.dxf, cup-plate.stl, cup.stl, hopper.stl, irsensor-support.dxf]
2026-10-17 Pitch deck: open on the deck on Vercel, drop chapter labels, add script
    - vercel.json redirects / to /pitch.html; the deck embeds the dashboard at /index.html
    - remove the "Measured, not claimed" slide and the chapter kickers
    - ALCOA+ on two rows, click-by-click problem and cost slides
    - pitch/SCRIPT.md: 5-minute spoken script
2026-10-17 Pitch deck: trim slides and closing line
    - closing line: "That's what we produced in 18 hours."
    - remove the signed-commands slide
    - drop the orange-rule text on the verification record, guards and screen slides
    - script renumbered to match
